bgomberg/MegaV/README.md

# MegaV
The goal of MegaV is to build a physical implementation of the RISC-V architecture. Specifically, MegaV will fully
implement the RV32E instruction set, and it will do so using only discrete logic.

## Current State
As of September 7th, 2025, the initial implementation is complete and validated and the 32-bit adder component of the
ALU has been designed and sent for manufacturing as an initial test board.

## License

The code within this repository is licensed under the [GPLv3 license](https://www.gnu.org/licenses/gpl-3.0.en.html)
license unless explicitly stated otherwise.

This repository includes a copy of the [RISC-V spec](https://github.com/riscv/riscv-isa-manual), which is licensed under
a Creative Commons Attribution 4.0 International License.
