bgomberg/MegaV/pcb/adder32/adder4.kicad_sch

## KiCad design pcb/adder32/adder4.kicad_sch (2025-09-07)

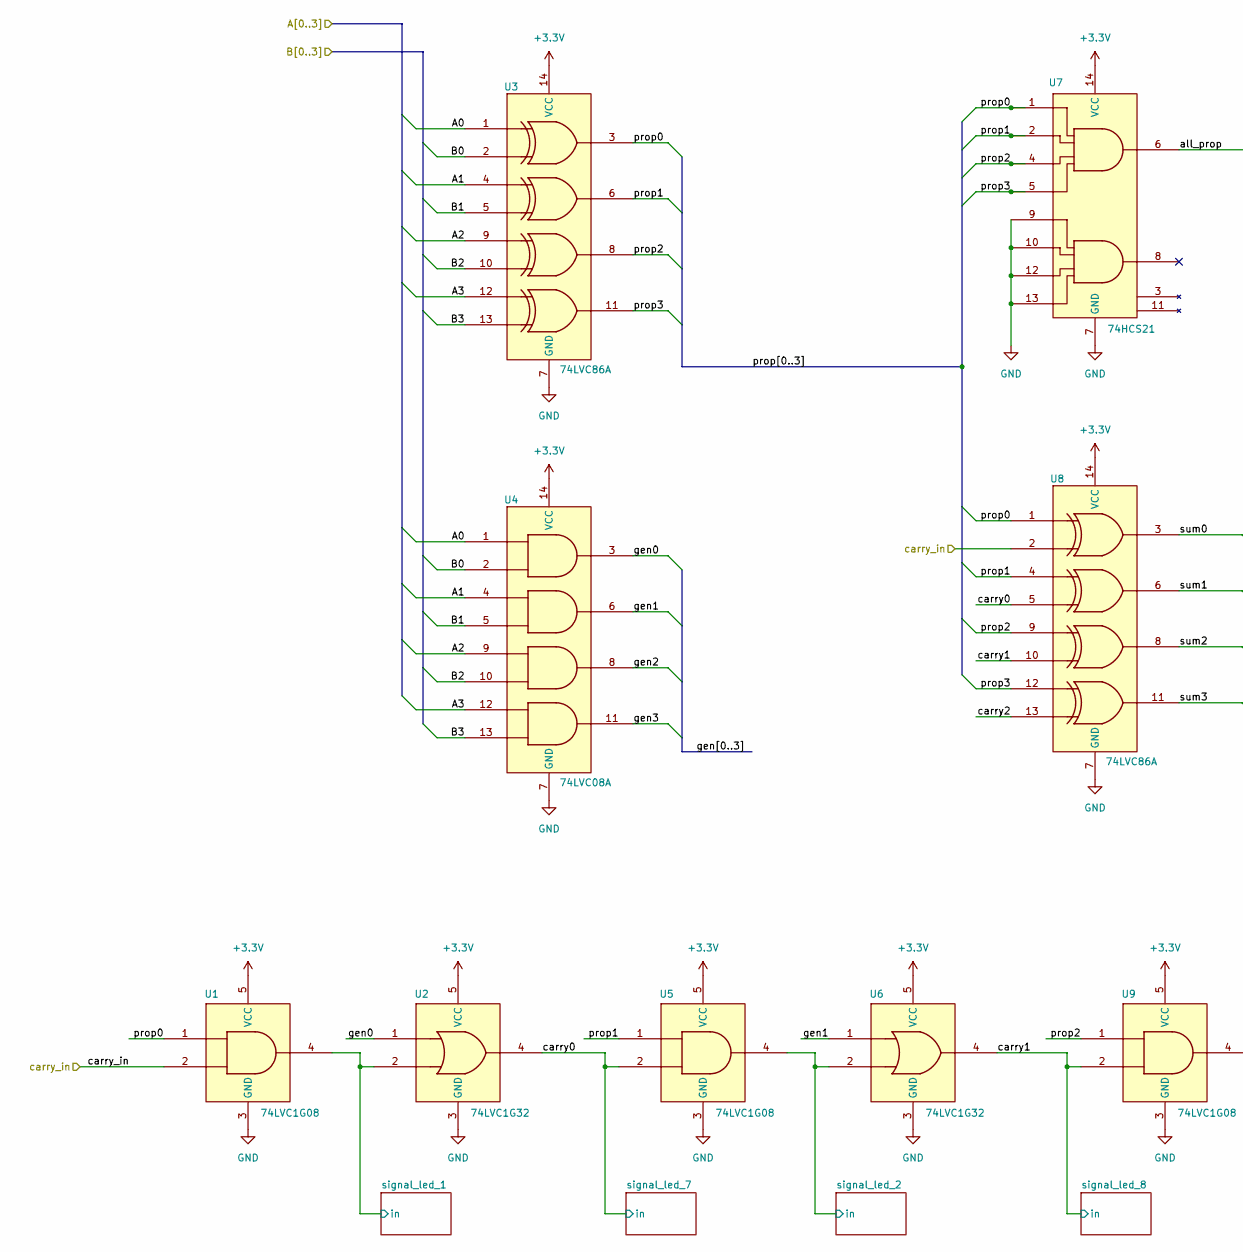
[picture p1: schematic adder4.kicad_sch, part in row 1, column 1]

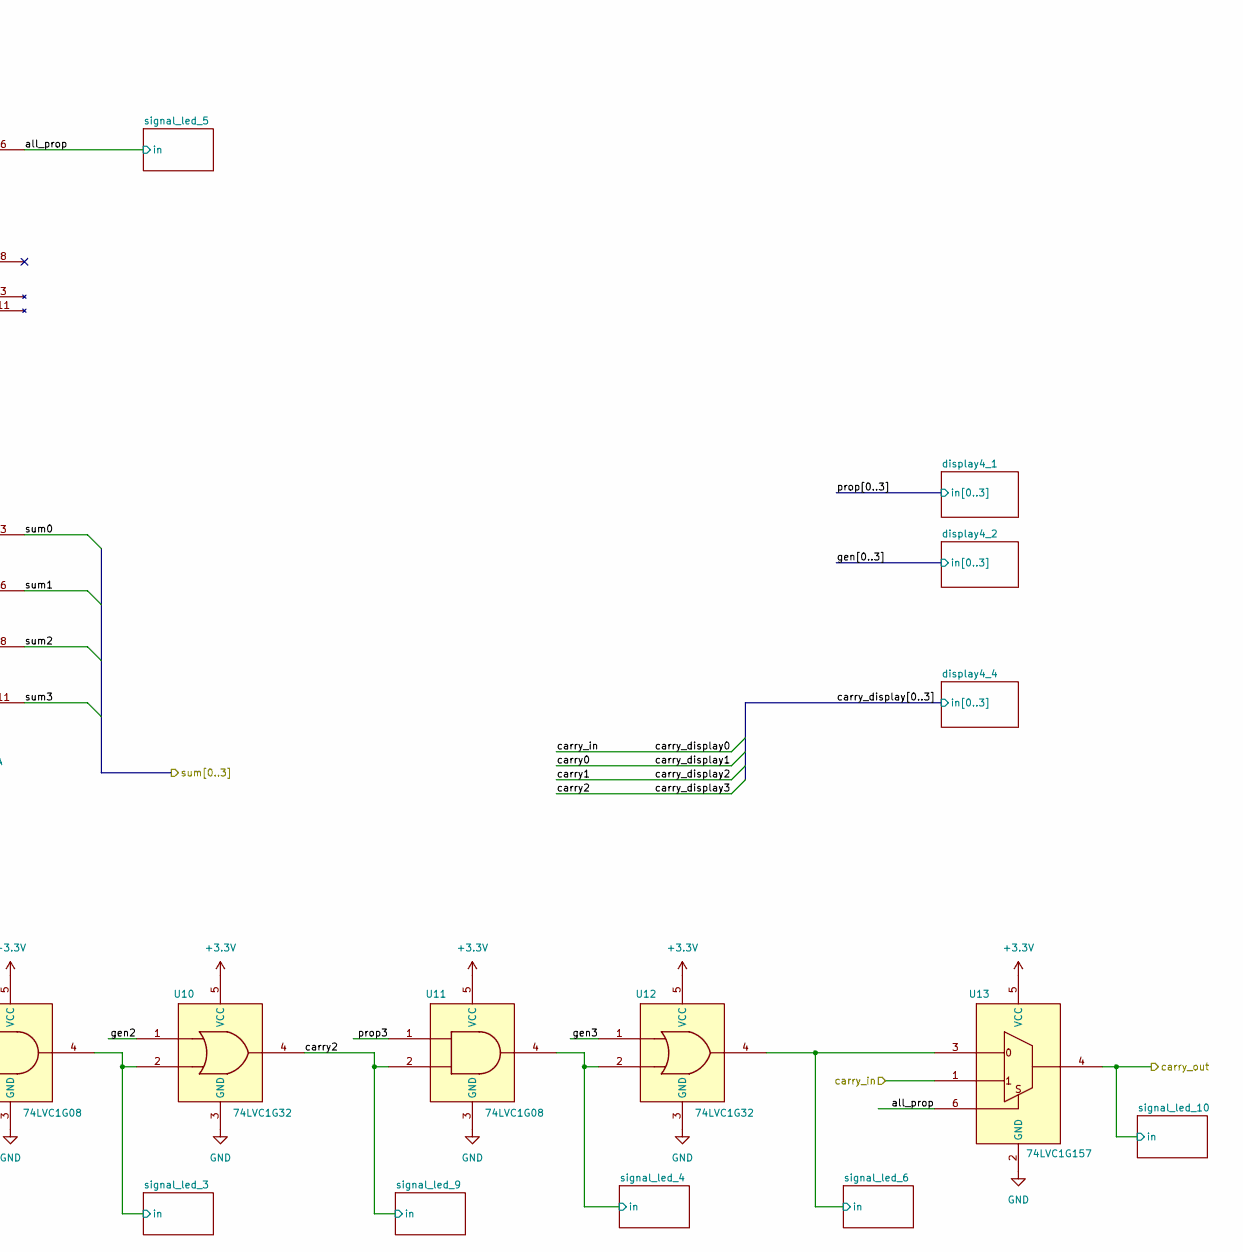
[picture p2: schematic adder4.kicad_sch, part in row 1, column 2]

Parts:
U1, U5, U9, U11: 74LVC1G08; SOT-353_SC-70-5
U2, U6, U10, U12: 74LVC1G32; SOT-353_SC-70-5
U3, U8: 74LVC86A; TSSOP-14_4.4x5mm_P0.65mm
U4: 74LVC08A; TSSOP-14_4.4x5mm_P0.65mm
U7: 74HCS21; TSSOP-14_4.4x5mm_P0.65mm
U13: 74LVC1G157; SOT-363_SC-70-6

Connections:
+3.3V: U1.5 (VCC), U2.5 (VCC), U3.14 (VCC), U4.14 (VCC), U5.5 (VCC), U6.5 (VCC), U7.14 (VCC), U8.14 (VCC), U9.5 (VCC), U10.5 (VCC), U11.5 (VCC), U12.5 (VCC), U13.5 (VCC)
A0: U3.1, U4.1
A1: U3.4, U4.4
A2: U3.9, U4.9
A3: U3.12, U4.12
B0: U3.2, U4.2
B1: U3.5, U4.5
B2: U3.10, U4.10
B3: U3.13, U4.13
GND: U1.3 (GND), U2.3 (GND), U3.7 (GND), U4.7 (GND), U5.3 (GND), U6.3 (GND), U7.7 (GND), U7.9, U7.10, U7.12, U7.13, U8.7 (GND), U9.3 (GND), U10.3 (GND), U11.3 (GND), U12.3 (GND), U13.2 (GND)
all_prop: U7.6, U13.6
carry0: U2.4, U5.2, U8.5
carry1: U6.4, U8.10, U9.2
carry2: U8.13, U10.4, U11.2
carry_display0: U1.2, U8.2, U13.1
carry_out: U13.4
gen0: U2.1, U4.3
gen1: U4.6, U6.1
gen2: U4.8, U10.1
gen3: U4.11, U12.1
in: U1.4, U2.2, U5.4, U6.2, U9.4, U10.2, U11.4, U12.2, U12.4, U13.3
prop0: U1.1, U3.3, U7.1, U8.1
prop1: U3.6, U5.1, U7.2, U8.4
prop2: U3.8, U7.4, U8.9, U9.1
prop3: U3.11, U7.5, U8.12, U11.1
sum0: U8.3
sum1: U8.6
sum2: U8.8
sum3: U8.11
