bgomberg/MegaV/pcb/adder32/display4.kicad_sch

## KiCad design pcb/adder32/display4.kicad_sch (2025-09-07)

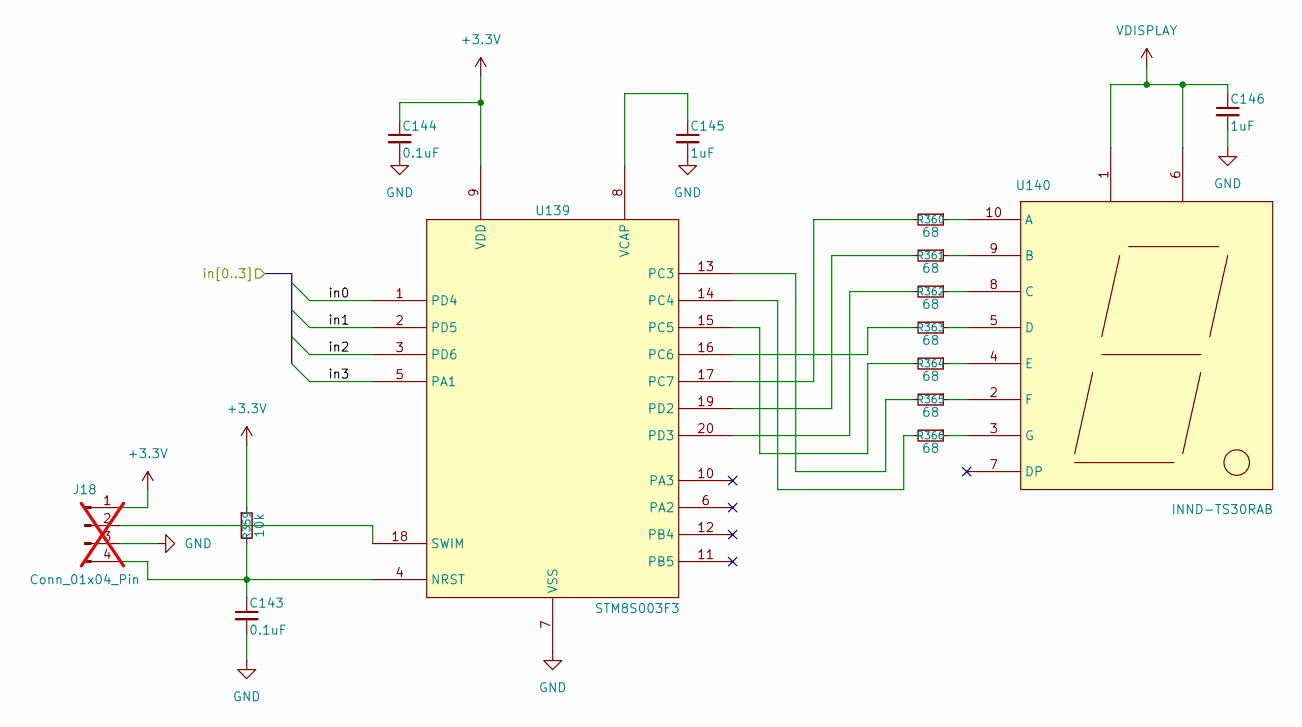
[picture p3: schematic display4.kicad_sch]

Parts:
C143, C144: 0.1uF; C_0805_2012Metric
C145, C146: 1uF; C_0805_2012Metric
J18: Conn_01x04_Pin; PinHeader_1x04_P2.54mm_Vertical; not fitted
R359: 10k; R_0603_1608Metric
R360, R361, R362, R363, R364, R365, R366: 68; R_0603_1608Metric
U139: STM8S003F3; TSSOP-20_4.4x6.5mm_P0.65mm
U140: INND-TS30RAB; 7SegmentLED_INND_TS30

Connections:
+3.3V: C144.1, J18.1, R359.1, U139.9 (VDD)
GND: C143.2, C144.2, C145.2, C146.2, J18.3, U139.7 (VSS)
unnamed: C143.1, J18.4, R359.2, U139.4 (NRST)
unnamed: C145.1, U139.8 (VCAP)
unnamed: J18.2, U139.18 (SWIM)
unnamed: R360.1, U140.10 (A)
unnamed: R360.2, U139.17 (PC7)
unnamed: R361.1, U140.9 (B)
unnamed: R361.2, U139.19 (PD2)
unnamed: R362.1, U140.8 (C)
unnamed: R362.2, U139.20 (PD3)
unnamed: R363.1, U140.5 (D)
unnamed: R363.2, U139.16 (PC6)
unnamed: R364.1, U140.4 (E)
unnamed: R364.2, U139.15 (PC5)
unnamed: R365.1, U140.2 (F)
unnamed: R365.2, U139.13 (PC3)
unnamed: R366.1, U140.3 (G)
unnamed: R366.2, U139.14 (PC4)
VDISPLAY: C146.1, U140.1, U140.6
in0: U139.1 (PD4)
in1: U139.2 (PD5)
in2: U139.3 (PD6)
in3: U139.5 (PA1)
