bgomberg/MegaV/pcb/adder32/display32.kicad_sch

## KiCad design pcb/adder32/display32.kicad_sch (2025-09-07)

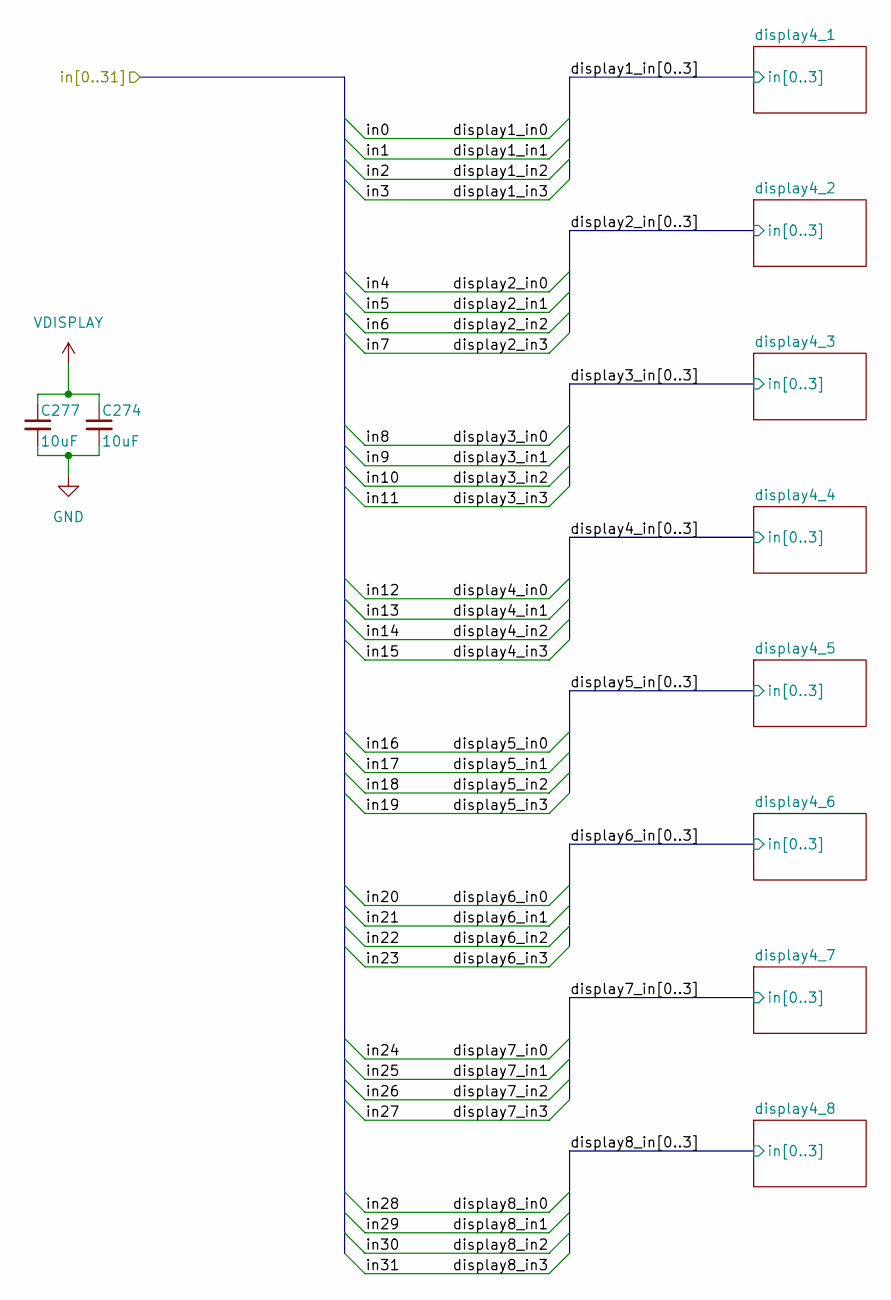
[picture p4: schematic display32.kicad_sch]

Parts:
C274, C277: 10uF; C_0805_2012Metric

Connections:
GND: C274.2, C277.2
VDISPLAY: C274.1, C277.1
