bgomberg/MegaV/pcb/adder32/logic.kicad_sch

## KiCad design pcb/adder32/logic.kicad_sch (2025-09-07)

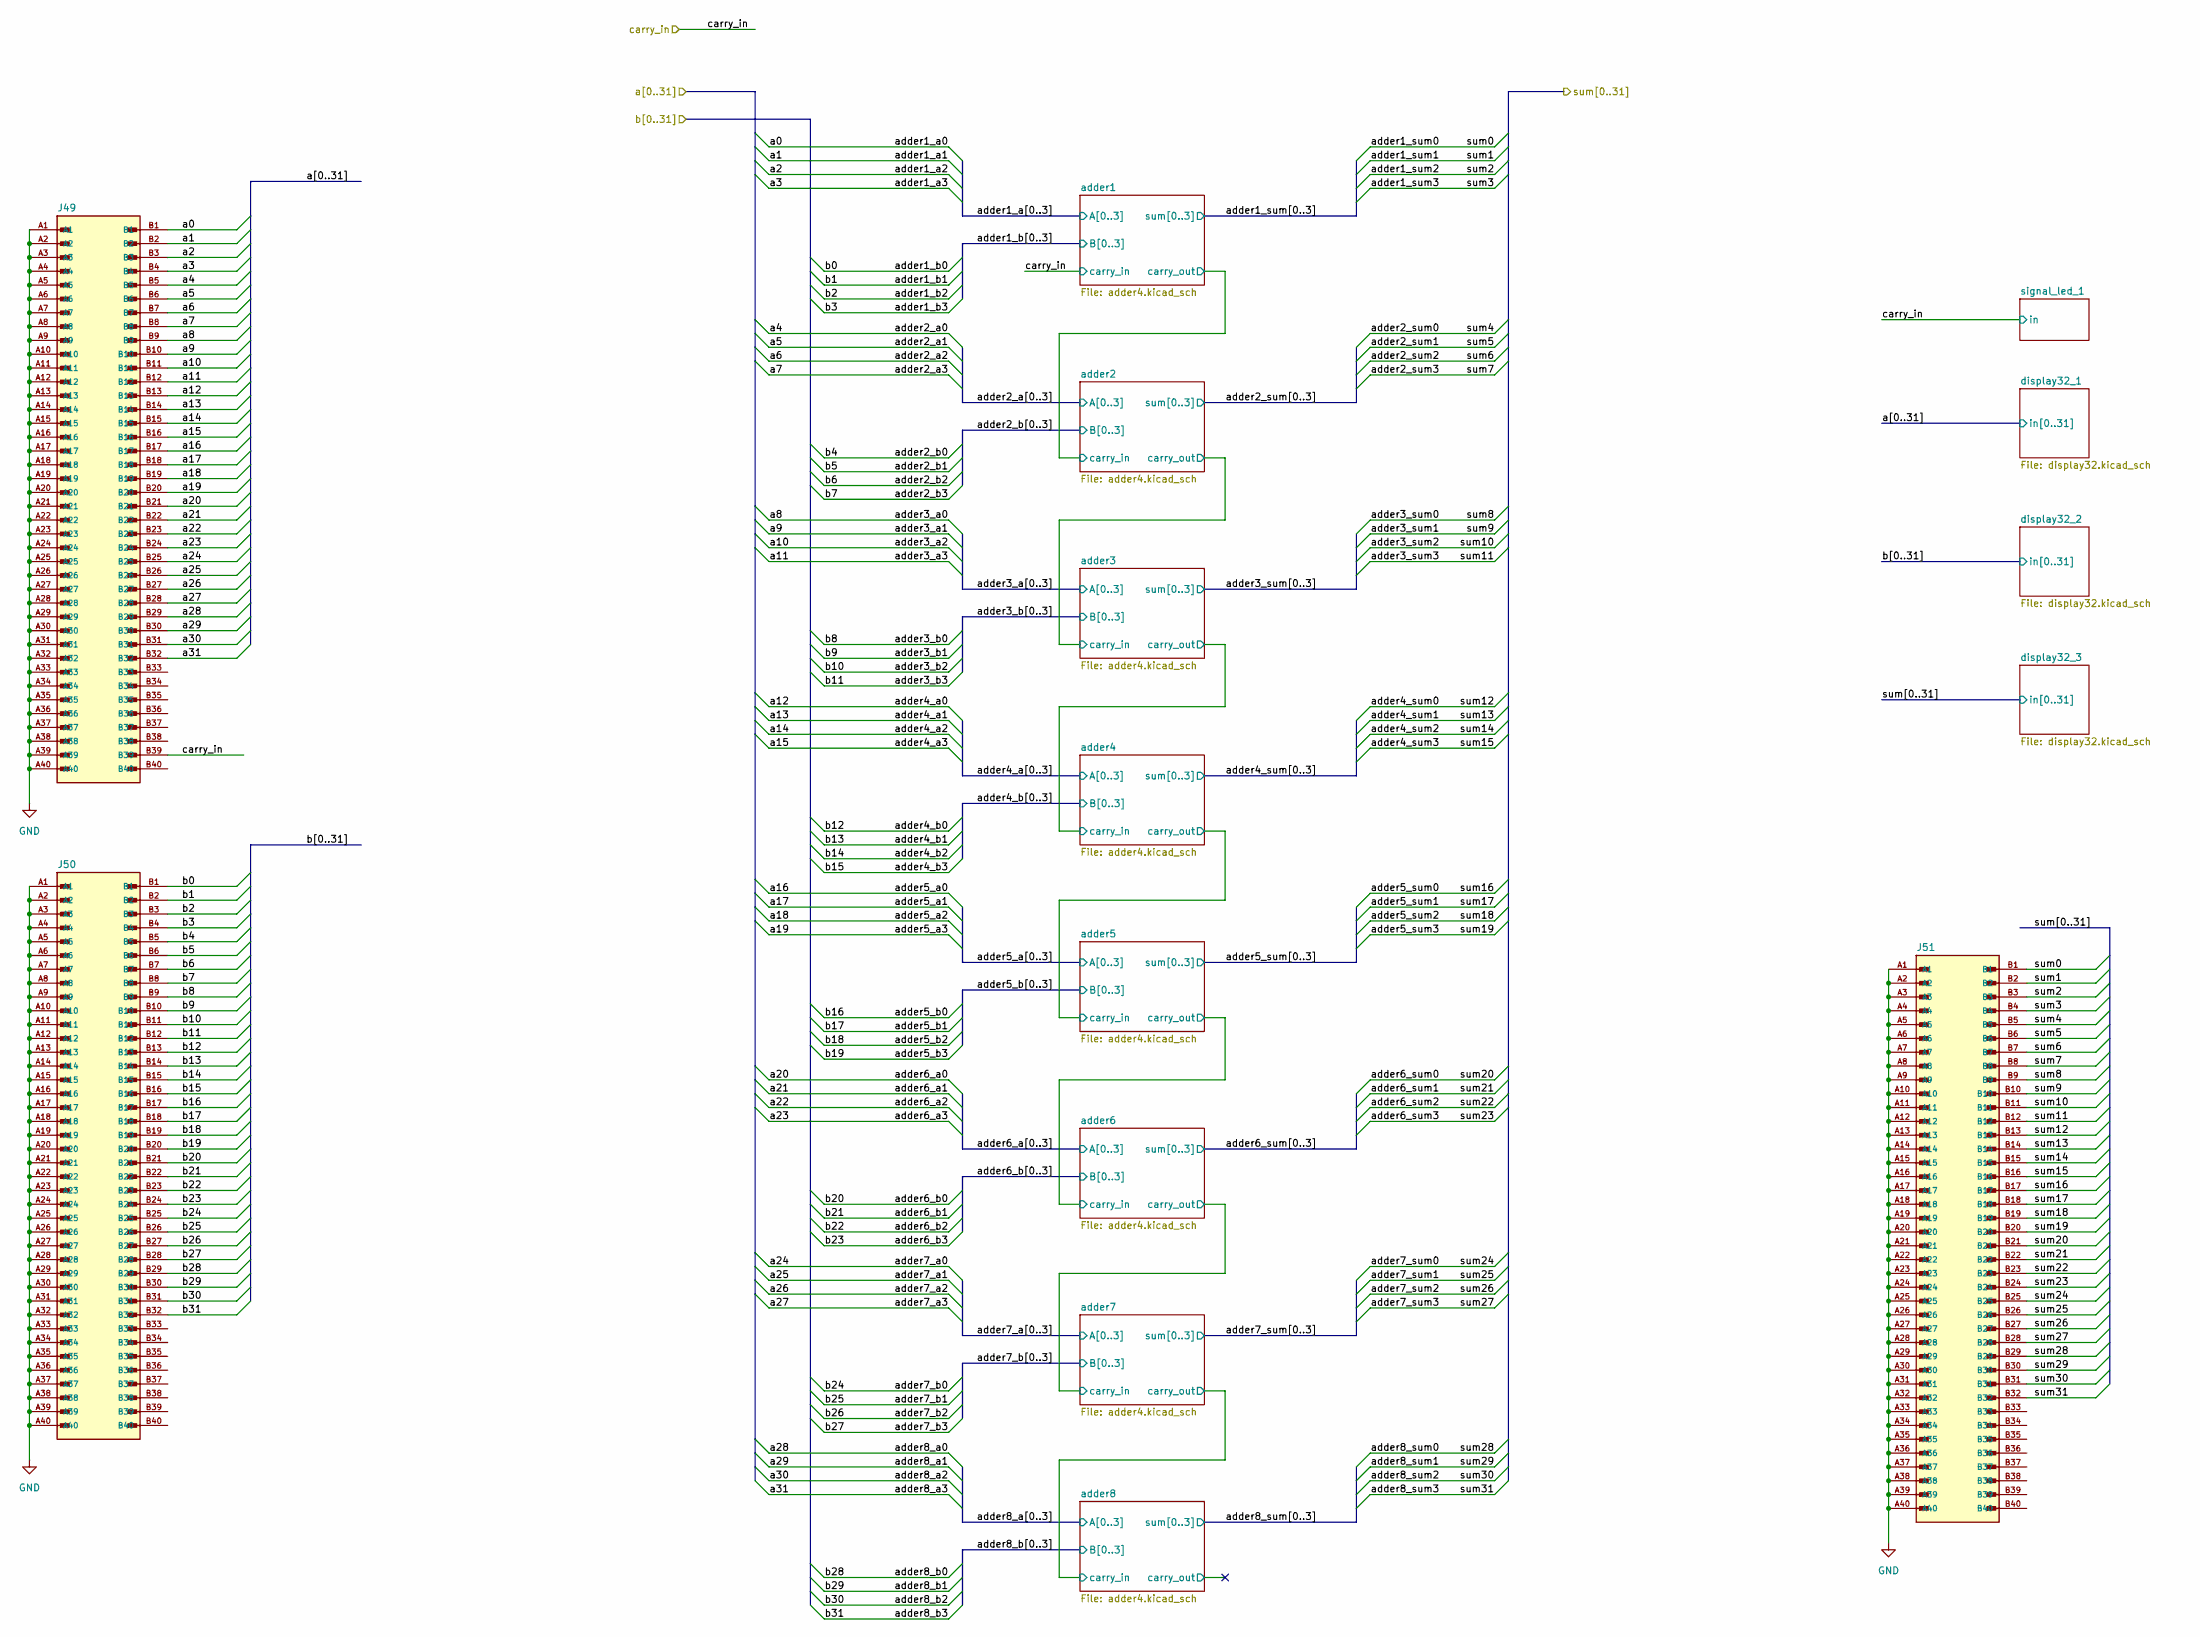
[picture p5: schematic logic.kicad_sch]

Parts:
J49, J50, J51: HIF6-80PA-1.27DSA_71_; HIROSE_HIF6-80PA-1.27DSA_71_

Connections:
GND: J49.A1, J49.A2, J49.A3, J49.A4, J49.A5, J49.A6, J49.A7, J49.A8, J49.A9, J49.A10, J49.A11, J49.A12, J49.A13, J49.A14, J49.A15, J49.A16, J49.A17, J49.A18, J49.A19, J49.A20, J49.A21, J49.A22, J49.A23, J49.A24, J49.A25, J49.A26, J49.A27, J49.A28, J49.A29, J49.A30, J49.A31, J49.A32, J49.A33, J49.A34, J49.A35, J49.A36, J49.A37, J49.A38, J49.A39, J49.A40, J50.A1, J50.A2, J50.A3, J50.A4, J50.A5, J50.A6, J50.A7, J50.A8, J50.A9, J50.A10, J50.A11, J50.A12, J50.A13, J50.A14, J50.A15, J50.A16, J50.A17, J50.A18, J50.A19, J50.A20, J50.A21, J50.A22, J50.A23, J50.A24, J50.A25, J50.A26, J50.A27, J50.A28, J50.A29, J50.A30, J50.A31, J50.A32, J50.A33, J50.A34, J50.A35, J50.A36, J50.A37, J50.A38, J50.A39, J50.A40, J51.A1, J51.A2, J51.A3, J51.A4, J51.A5, J51.A6, J51.A7, J51.A8, J51.A9, J51.A10, J51.A11, J51.A12, J51.A13, J51.A14, J51.A15, J51.A16, J51.A17, J51.A18, J51.A19, J51.A20, J51.A21, J51.A22, J51.A23, J51.A24, J51.A25, J51.A26, J51.A27, J51.A28, J51.A29, J51.A30, J51.A31, J51.A32, J51.A33, J51.A34, J51.A35, J51.A36, J51.A37, J51.A38, J51.A39, J51.A40
a0: J49.B1
a1: J49.B2
a2: J49.B3
a3: J49.B4
a4: J49.B5
a5: J49.B6
a6: J49.B7
a7: J49.B8
a8: J49.B9
a9: J49.B10
a10: J49.B11
a11: J49.B12
a12: J49.B13
a13: J49.B14
a14: J49.B15
a15: J49.B16
a16: J49.B17
a17: J49.B18
a18: J49.B19
a19: J49.B20
a20: J49.B21
a21: J49.B22
a22: J49.B23
a23: J49.B24
a24: J49.B25
a25: J49.B26
a26: J49.B27
a27: J49.B28
a28: J49.B29
a29: J49.B30
a30: J49.B31
a31: J49.B32
adder1_b0: J50.B1
adder1_b1: J50.B2
adder1_b2: J50.B3
adder1_b3: J50.B4
adder1_sum0: J51.B1
adder1_sum1: J51.B2
adder1_sum2: J51.B3
adder1_sum3: J51.B4
adder2_b0: J50.B5
adder2_b1: J50.B6
adder2_b2: J50.B7
adder2_b3: J50.B8
adder2_sum0: J51.B5
adder2_sum1: J51.B6
adder2_sum2: J51.B7
adder2_sum3: J51.B8
adder3_b0: J50.B9
adder3_b1: J50.B10
adder3_b2: J50.B11
adder3_b3: J50.B12
adder3_sum0: J51.B9
adder3_sum1: J51.B10
adder3_sum2: J51.B11
adder3_sum3: J51.B12
adder4_b0: J50.B13
adder4_b1: J50.B14
adder4_b2: J50.B15
adder4_b3: J50.B16
adder4_sum0: J51.B13
adder4_sum1: J51.B14
adder4_sum2: J51.B15
adder4_sum3: J51.B16
adder5_b0: J50.B17
adder5_b1: J50.B18
adder5_b2: J50.B19
adder5_b3: J50.B20
adder5_sum0: J51.B17
adder5_sum1: J51.B18
adder5_sum2: J51.B19
adder5_sum3: J51.B20
adder6_b0: J50.B21
adder6_b1: J50.B22
adder6_b2: J50.B23
adder6_b3: J50.B24
adder6_sum0: J51.B21
adder6_sum1: J51.B22
adder6_sum2: J51.B23
adder6_sum3: J51.B24
adder7_b0: J50.B25
adder7_b1: J50.B26
adder7_b2: J50.B27
adder7_b3: J50.B28
adder7_sum0: J51.B25
adder7_sum1: J51.B26
adder7_sum2: J51.B27
adder7_sum3: J51.B28
adder8_b0: J50.B29
adder8_b1: J50.B30
adder8_b2: J50.B31
adder8_b3: J50.B32
adder8_sum0: J51.B29
adder8_sum1: J51.B30
adder8_sum2: J51.B31
adder8_sum3: J51.B32
carry_in: J49.B39
