bgomberg/MegaV/pcb/adder32/power.kicad_sch

## KiCad design pcb/adder32/power.kicad_sch (2025-09-07)

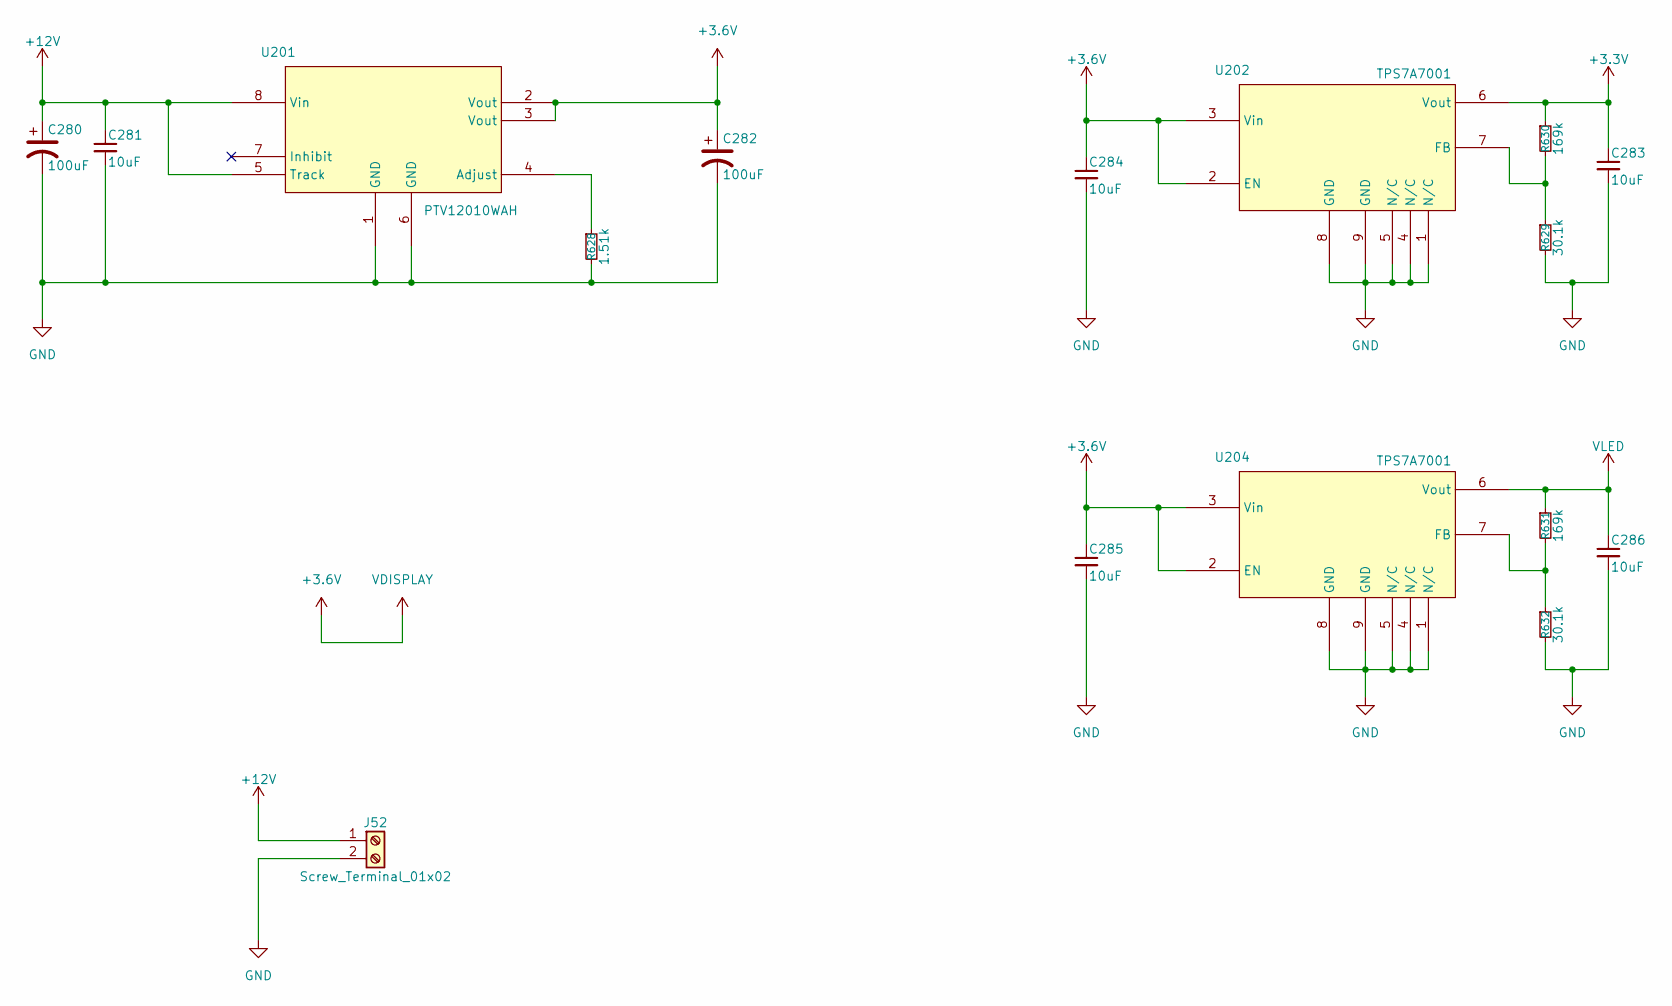
[picture p6: schematic power.kicad_sch]

Parts:
C280, C282: 100uF; CP_Elec_6.3x7.7
C281, C283, C284, C285, C286: 10uF; C_0805_2012Metric
J52: Screw_Terminal_01x02; TerminalBlock_CUI_TB007-508-02_1x02_P5.08mm_Horizontal
R628: 1.51k; R_0603_1608Metric
R629, R632: 30.1k; R_0603_1608Metric
R630, R631: 169k; R_0603_1608Metric
U201: PTV12010WAH; EVA8
U202, U204: TPS7A7001; VREG_LM5017MR_NOPB

Connections:
+3.3V: C283.1, R630.1, U202.6 (Vout)
+3.6V: C282.1, C284.1, C285.1, U201.2 (Vout), U201.3 (Vout), U202.2 (EN), U202.3 (Vin), U204.2 (EN), U204.3 (Vin)
+12V: C280.1, C281.1, J52.1, U201.5 (Track), U201.8 (Vin)
GND: C280.2, C281.2, C282.2, C283.2, C284.2, C285.2, C286.2, J52.2, R628.2, R629.2, R632.2, U201.1 (GND), U201.6 (GND), U202.1 (N/C), U202.4 (N/C), U202.5 (N/C), U202.8 (GND), U202.9 (GND), U204.1 (N/C), U204.4 (N/C), U204.5 (N/C), U204.8 (GND), U204.9 (GND)
unnamed: R628.1, U201.4 (Adjust)
unnamed: R629.1, R630.2, U202.7 (FB)
unnamed: R631.2, R632.1, U204.7 (FB)
VLED: C286.1, R631.1, U204.6 (Vout)
