bgomberg/MegaV/pcb/adder32/signal_led.kicad_sch

## KiCad design pcb/adder32/signal_led.kicad_sch (2025-09-07)

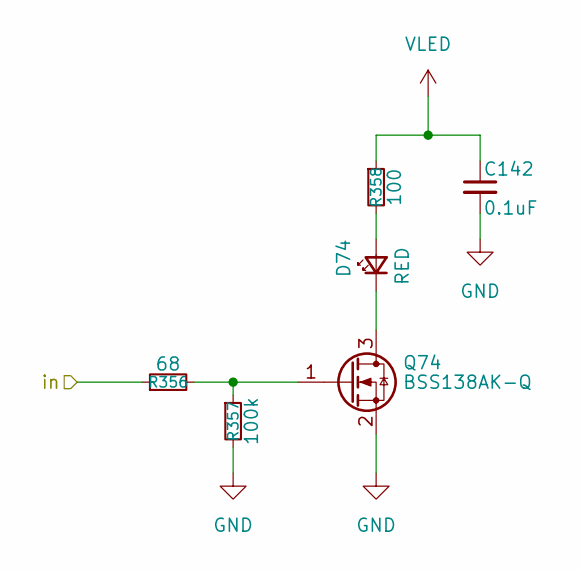
[picture p7: schematic signal_led.kicad_sch]

Parts:
C142: 0.1uF; C_0805_2012Metric
D74: RED; LED_0805_2012Metric
Q74: BSS138AK-Q; SOT-23
R356: 68; R_0603_1608Metric
R357: 100k; R_0603_1608Metric
R358: 100; R_0603_1608Metric

Connections:
GND: C142.2, Q74.2 (S), R357.2
unnamed: D74.1 (K), Q74.3 (D)
unnamed: D74.2 (A), R358.2
unnamed: Q74.1 (G), R356.2, R357.1
VLED: C142.1, R358.1
in: R356.1
