bgomberg/MegaV/(commit log)

2019-06-10 Integrate assembly test program into sim
2019-06-18 More work on CSR / some bug fixes
    [core.sv, csr.sv, instruction_decode.sv]
2019-06-21 Optimized addr4 to take gen/prop as inputs
2019-06-21 Optimized adder32 to take gen/prop as inputs
2019-07-03 Change reset to active low
    [alu.sv, core.sv, csr.sv, fsm.sv, instruction_decode.sv, memory.sv]
2019-07-05 Added support for external interrupt
2019-07-05 Implemented SW interrupts
2025-09-07 CSR fixes / cleanup
    [csr.sv]
2025-09-07 Active low stage_active signals
2025-09-07 Version 1 adder32 PCB files
    [adder32.kicad_sch, adder4.kicad_sch, display32.kicad_sch, display4.kicad_sch, logic.kicad_sch, power.kicad_sch, signal_led.kicad_sch]
